evezor/potentiometer_board/README.md

# Potentiometer Board
An edge board containing two potentiometers, two bar graph leds and two buttons
