evezor/potentiometer_board/cad_files/POTENTIOMETER.pdf

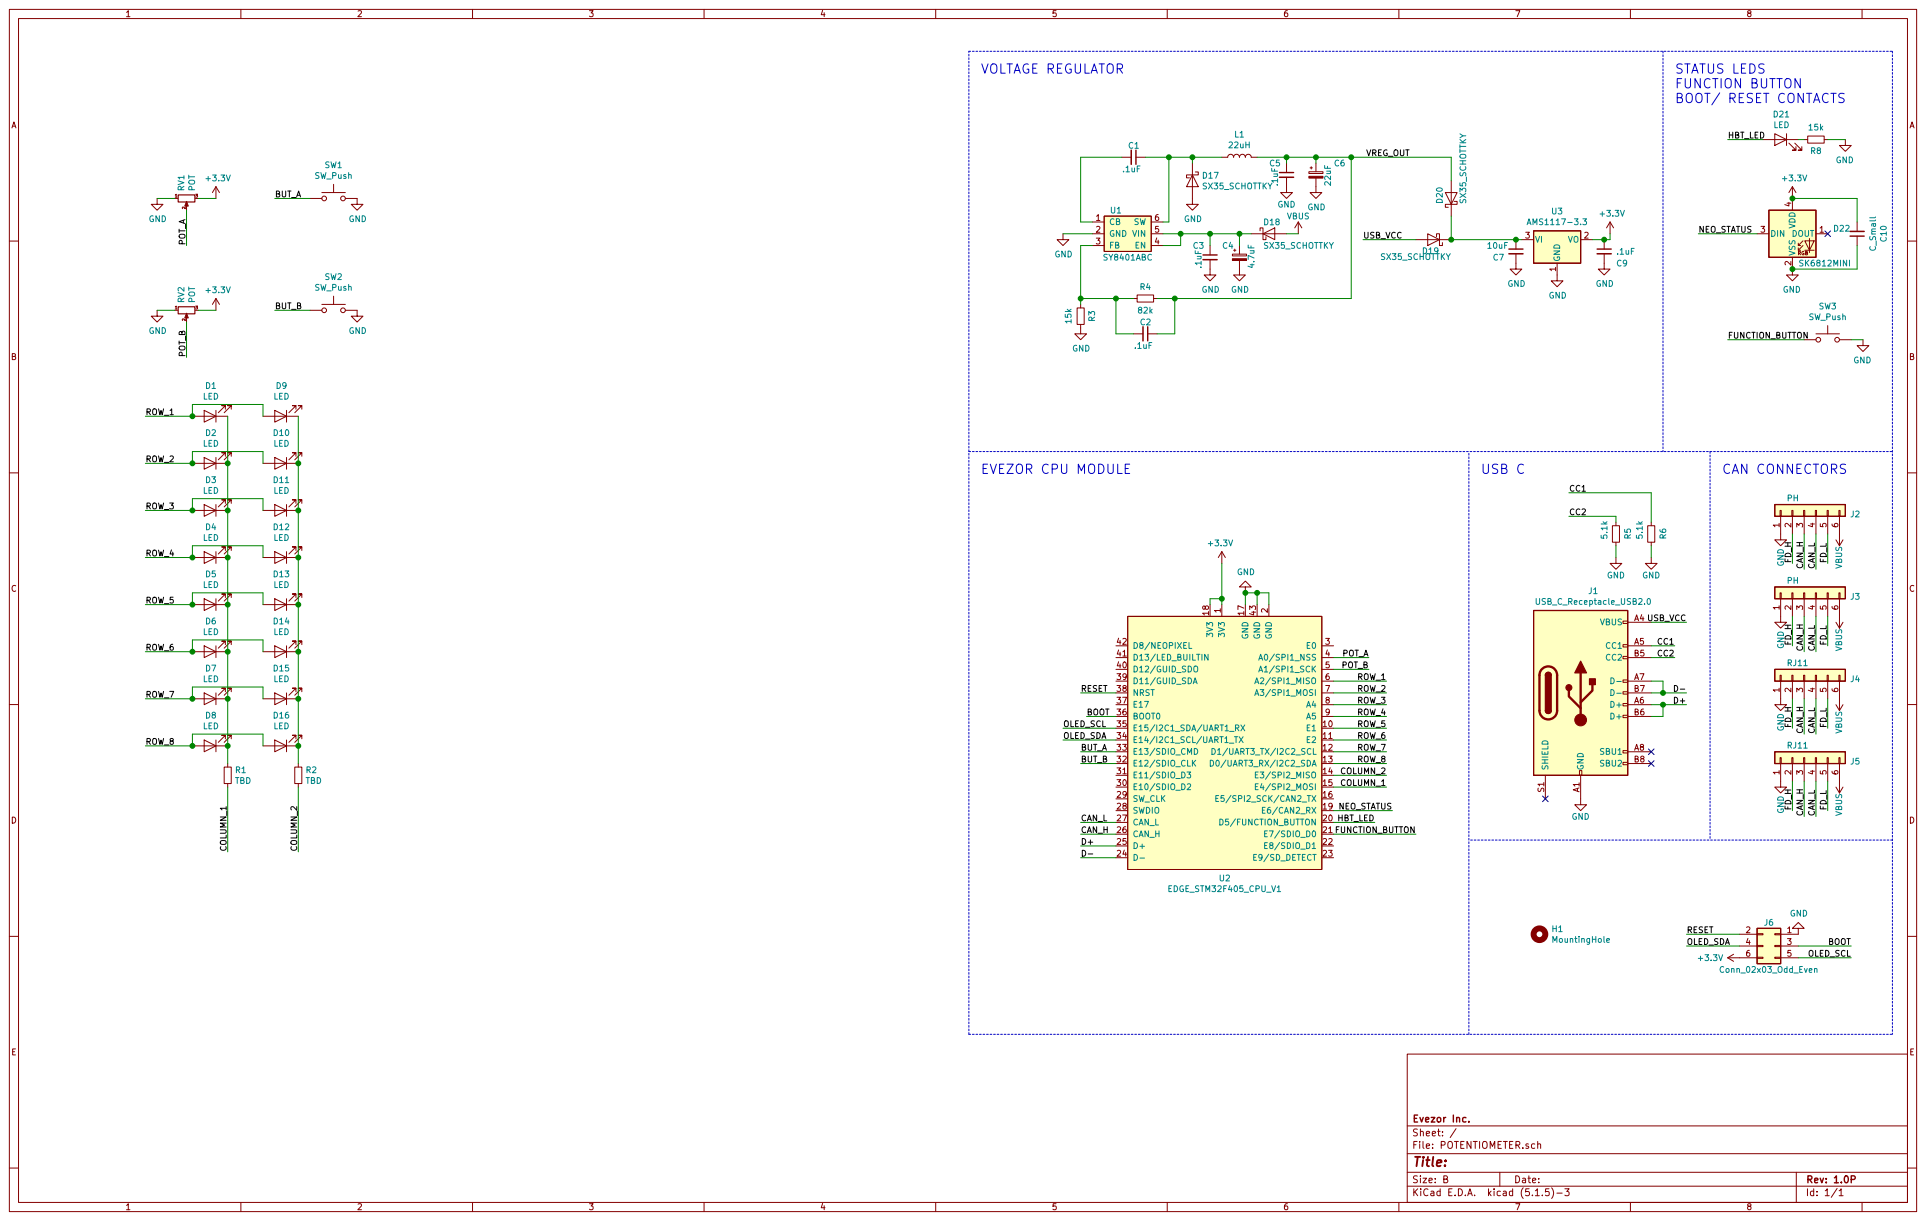
[picture p1: page 1]
