evezor/potentiometer_board/cad_files/POTENTIOMETER.kicad_pcb

## KiCad design cad_files/POTENTIOMETER.kicad_pcb (2020-11-06)

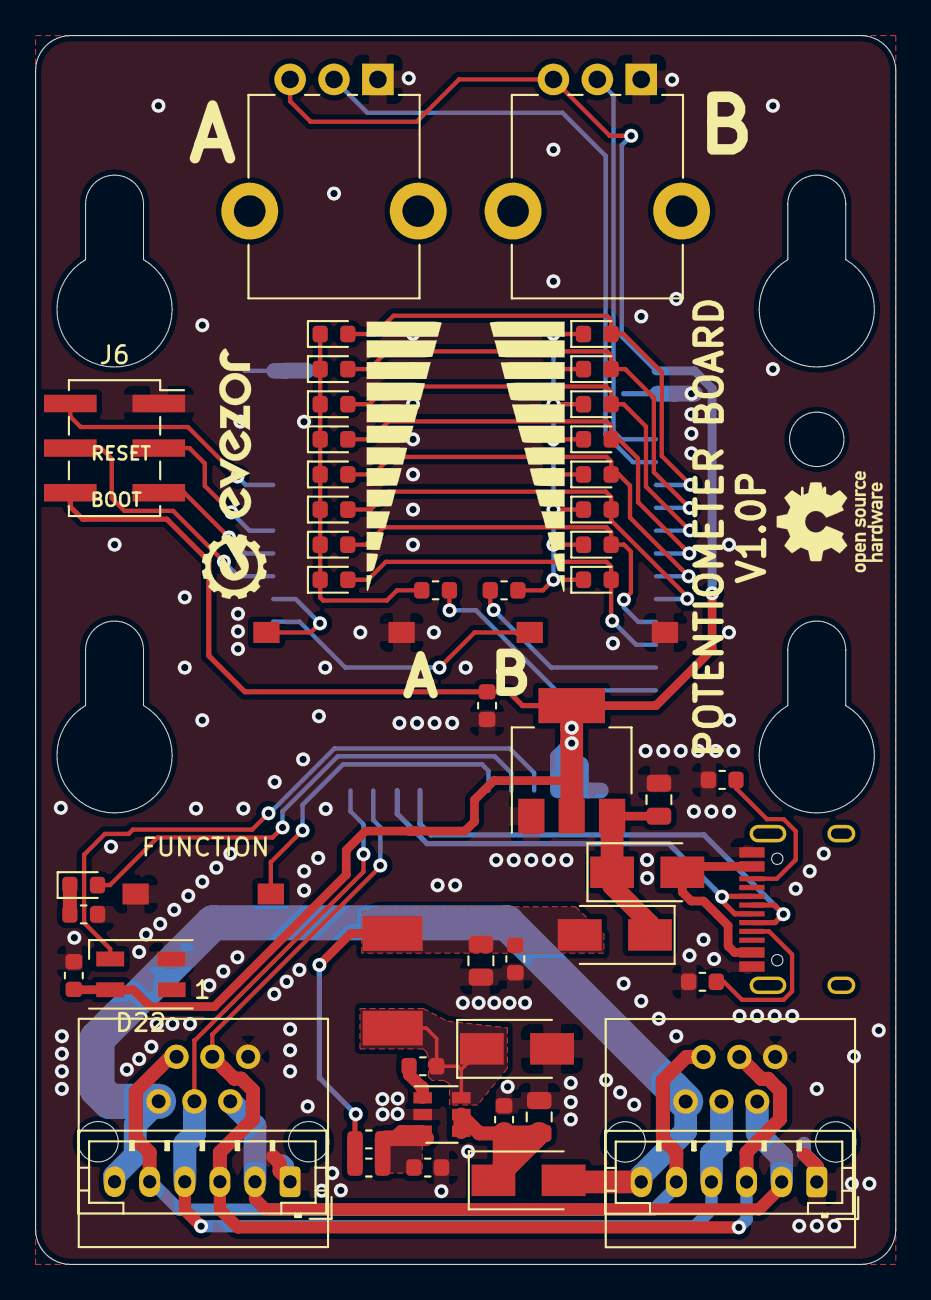
[picture p2: board POTENTIOMETER.kicad_pcb from above]

Board: 2 copper layers, 49.0 x 70.0 mm, 54 parts (1 on the bottom side), 42 nets.

Parts:
C1, C2, C3, C5, C9: .1uF; C_0603_1608Metric
C4: 4.7uF; C_0805_2012Metric
C6: 22uF; C_0805_2012Metric
C7: 10uF; C_0805_2012Metric
C10: C_Small; C_0603_1608Metric
D1, D2, D3, D4, D5, D6, D7, D8, D9, D10, D11, D12, D13, D14, D15, D16, D21: LED; LED_0603_1608Metric
D17, D18, D19, D20: SX35_SCHOTTKY; D_SMA
D22: SK6812MINI; LED_SK6812MINI_PLCC4_3.5x3.5mm_P1.75mm
H1: MountingHole; OLED_STANDOFF
J1: USB_C_Receptacle_USB2.0; USB_C_Receptacle_HRO_TYPE-C-31-M-12
J2, J3: PH; JST_PH_B6B-PH-K_1x06_P2.00mm_Vertical
J4, J5: RJ11; RJ11_C189747_Horizontal
J6: Conn_02x03_Odd_Even; OLED_HEADER
L1: 22uH; INDUCTOR_7.5X6.6_GCDA0630-220MC
R1, R2: TBD; R_0603_1608Metric
R3, R8: 15k; R_0603_1608Metric
R4: 82k; R_0603_1608Metric
R5, R6: 5.1k; R_0603_1608Metric
RV1, RV2: POT; Potentiometer_Alpha_RD901F-40-00D_Single_Vertical_CircularH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
SW1, SW2, SW3: SW_Push; SWITCH_2x3_SMD_TACTILE_GREEN
U1: SY8401ABC; SOT-23-6
U2: EDGE_STM32F405_CPU_V1; EDGE_STAMP
U3: AMS1117-3.3; SOT-223-3_TabPin2

Connections:
+3V3: C9.1, C10.2, D22.4, J6.6, RV1.3, RV2.3, U2.1, U2.18, U3.2
/BOOT: J6.3, U2.36
/BUT_A: SW1.1, U2.33
/BUT_B: SW2.1, U2.32
/CAN_H: J2.3, J3.3, J4.3, J5.3, U2.26
/CAN_L: J2.4, J3.4, J4.4, J5.4, U2.27
/CC1: J1.A5, R6.1
/CC2: J1.B5, R5.1
/COLUMN_1: R1.2, U2.15
/COLUMN_2: R2.2, U2.14
/D+: J1.A6, J1.B6, U2.25
/D-: J1.A7, J1.B7, U2.24
/FD_H: J2.2, J3.2, J4.2, J5.2
/FD_L: J2.5, J3.5, J4.5, J5.5
/FUNCTION_BUTTON: SW3.1, U2.21
/HBT_LED: D21.2, U2.20
/NEO_STATUS: D22.3, U2.19
/OLED_SCL: J6.5, U2.35
/OLED_SDA: J6.4, U2.34
/POT_A: RV1.2, U2.4
/POT_B: RV2.2, U2.5
/RESET: J6.2, U2.38
/ROW_1: D1.2, D9.2, U2.6
/ROW_2: D2.2, D10.2, U2.7
/ROW_3: D3.2, D11.2, U2.8
/ROW_4: D4.2, D12.2, U2.9
/ROW_5: D5.2, D13.2, U2.10
/ROW_6: D6.2, D14.2, U2.11
/ROW_7: D7.2, D15.2, U2.12
/ROW_8: D8.2, D16.2, U2.13
/USB_VCC: D19.2, J1.A4, J1.A9, J1.B4, J1.B9
/VREG_OUT: C2.1, C5.1, C6.1, D20.2, L1.2, R4.1
GND: C3.2, C4.2, C5.2, C6.2, C7.2, C9.2, C10.1, D17.2, D22.2, J1.A1, J1.A12, J1.B1, J1.B12, J2.1, J3.1, J4.1, J5.1, J6.1, R3.1, R5.2, R6.2, R8.1, RV1.1, RV2.1, SW1.2, SW2.2, SW3.2, U1.2, U2.2, U2.17, U2.43, U3.1
unnamed: C1.1, D17.1, L1.1, U1.6
unnamed: C1.2, U1.1
unnamed: C2.2, R3.2, R4.2, U1.3
unnamed: C3.1, C4.1, D18.1, U1.4, U1.5
unnamed: C7.1, D19.1, D20.1, U3.3
unnamed: D1.1, D2.1, D3.1, D4.1, D5.1, D6.1, D7.1, D8.1, R1.1
unnamed: D9.1, D10.1, D11.1, D12.1, D13.1, D14.1, D15.1, D16.1, R2.1
unnamed: D21.1, R8.2
VBUS: D18.2, J2.6, J3.6, J4.6, J5.6
